Jay-esp/CB-radio-Cybernet-platform-PLL-controller/cb_pllcontrol_1_0_topview2.png

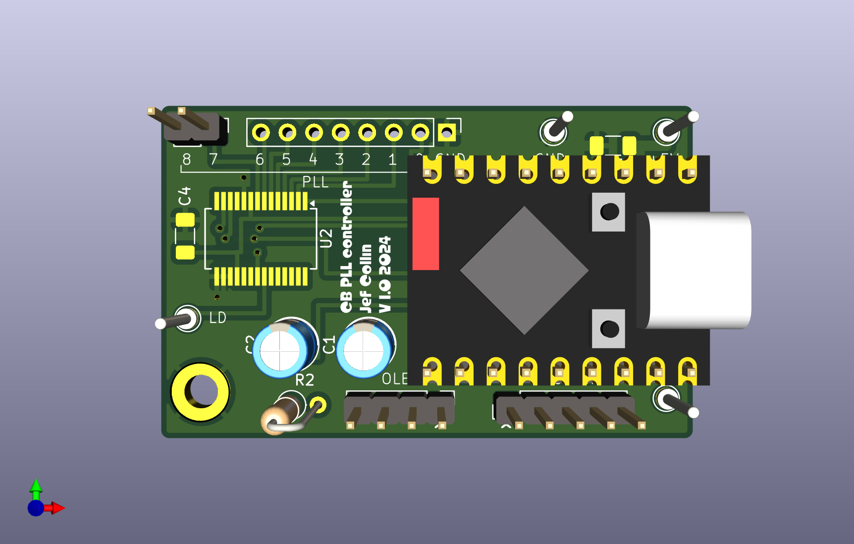
cb_pllcontrol_1_0_topview2.png
