Jay-esp/CB-radio-Cybernet-platform-PLL-controller/cb_pllcontrol_1_0.pdf

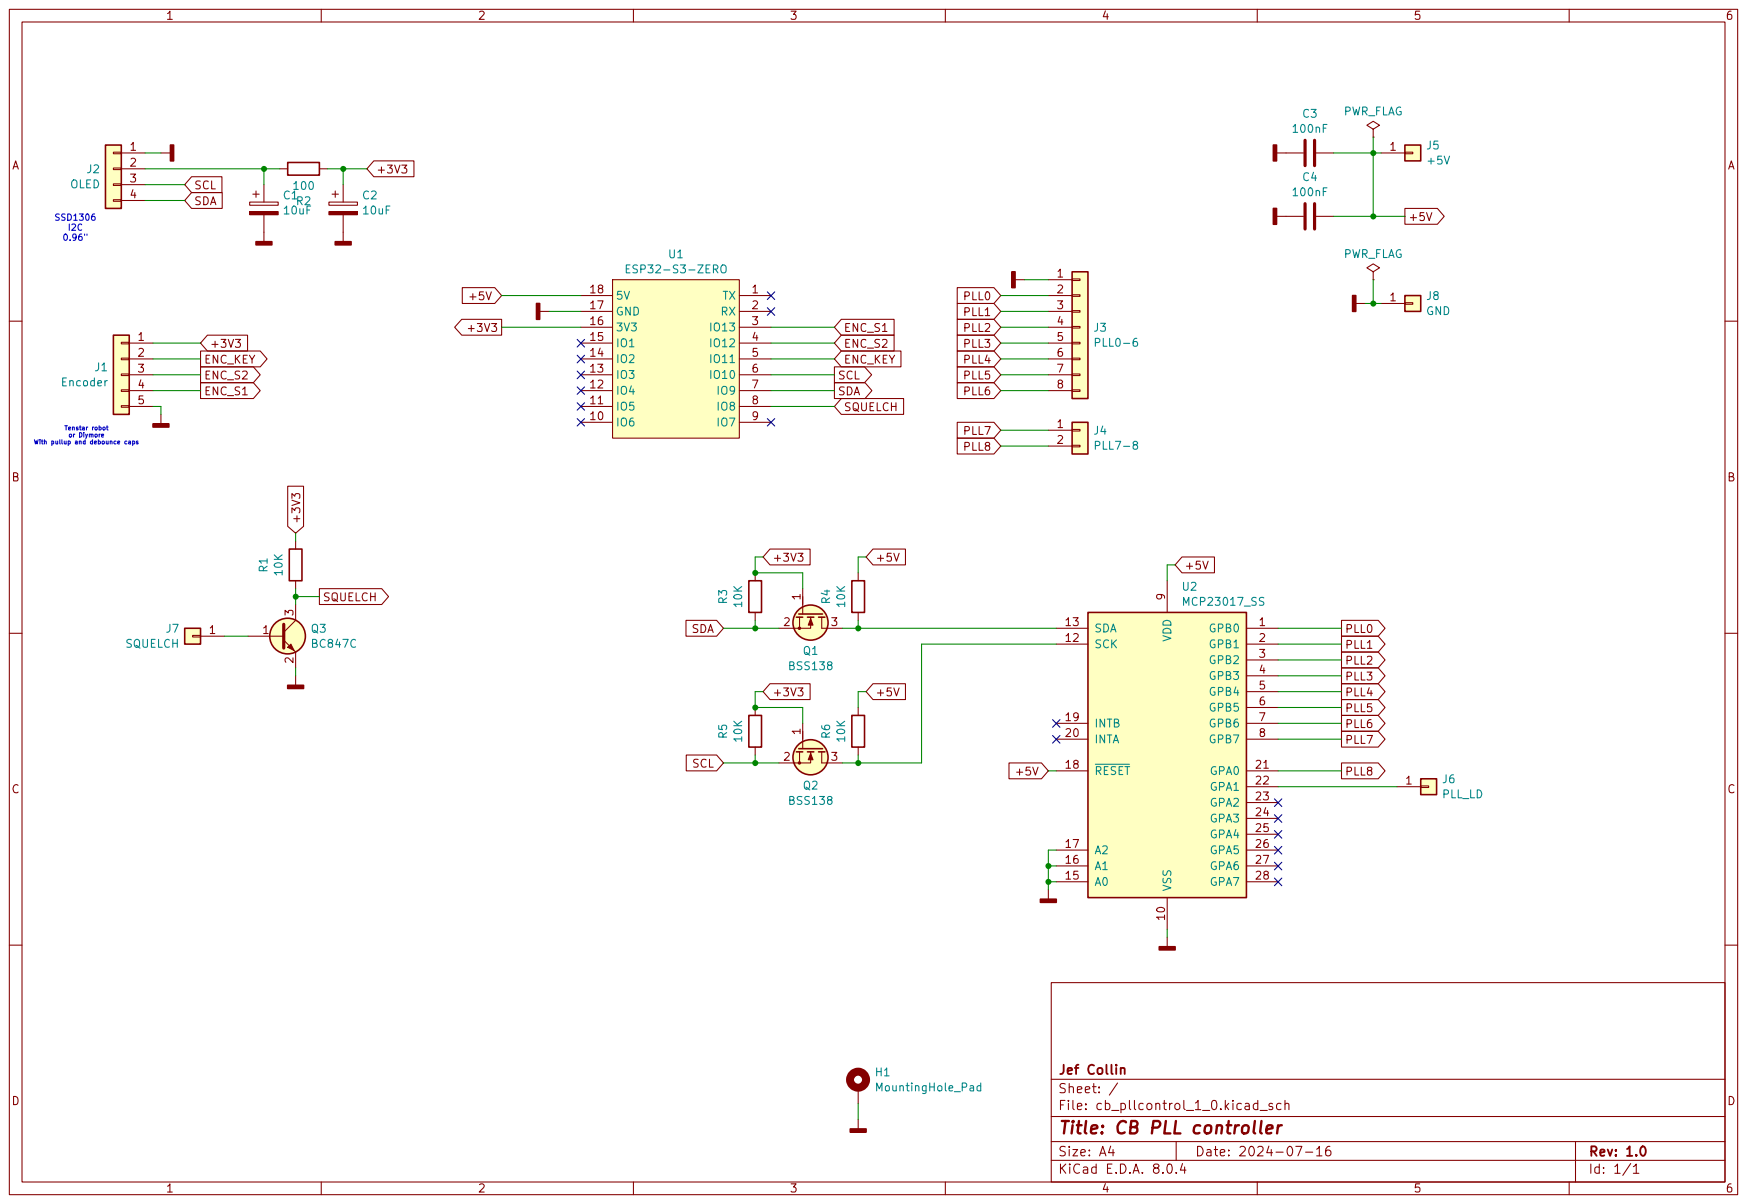
[picture p34: page 1]
