Jay-esp/CB-radio-Cybernet-platform-PLL-controller/CB_PLL_1_2/Roboto_Regular10pt7b.h

const uint8_t Roboto_Regular10pt7bBitmaps[] PROGMEM = {
  0x00, 0xFA, 0xAA, 0xA0, 0xF0, 0xDD, 0xDD, 0x90, 0x0C, 0xC1, 0x10, 0x22,
  0x3F, 0xF1, 0x98, 0x33, 0x04, 0x40, 0x88, 0xFF, 0xC6, 0x60, 0xCC, 0x19,
  0x02, 0x20, 0x44, 0x00, 0x0C, 0x06, 0x0F, 0x8F, 0xE6, 0x3A, 0x0D, 0x86,
  0xE0, 0x3E, 0x07, 0x80, 0xE0, 0x3C, 0x1F, 0x0D, 0xFC, 0x7C, 0x08, 0x04,
  0x00, 0x78, 0x06, 0x40, 0x23, 0x11, 0x19, 0x88, 0xC8, 0x64, 0x81, 0xEC,
  0x00, 0x5E, 0x05, 0x90, 0x68, 0xC2, 0x46, 0x22, 0x33, 0x19, 0x00, 0x78,
  0x1E, 0x07, 0xE1, 0x8C, 0x31, 0x86, 0x30, 0x7C, 0x06, 0x03, 0xE0, 0xC6,
  0x78, 0x6B, 0x07, 0x70, 0xC7, 0xFC, 0x7C, 0xC0, 0xF8, 0x08, 0xC4, 0x66,
  0x31, 0x88, 0xC6, 0x31, 0x8C, 0x21, 0x8C, 0x61, 0x84, 0x30, 0x80, 0x81,
  0x82, 0x0C, 0x10, 0x61, 0x86, 0x08, 0x30, 0xC3, 0x08, 0x61, 0x86, 0x10,
  0xC2, 0x18, 0x80, 0x08, 0x08, 0x49, 0xFF, 0x18, 0x3C, 0x26, 0x62, 0x0C,
  0x03, 0x00, 0xC0, 0x30, 0xFF, 0xFF, 0xF0, 0xC0, 0x30, 0x0C, 0x03, 0x00,
  0xC0, 0x6D, 0xAC, 0xFF, 0xC0, 0x7C, 0x03, 0x02, 0x06, 0x04, 0x0C, 0x08,
  0x08, 0x18, 0x10, 0x30, 0x30, 0x20, 0x60, 0x40, 0xC0, 0x3E, 0x3F, 0x98,
  0xF8, 0x3C, 0x1E, 0x0F, 0x07, 0x83, 0xC1, 0xE0, 0xF0, 0x6C, 0x77, 0xF1,
  0xF0, 0x0B, 0xFF, 0x31, 0x8C, 0x63, 0x18, 0xC6, 0x31, 0x8C, 0x3E, 0x1F,
  0xCE, 0x3B, 0x06, 0x01, 0x80, 0x40, 0x30, 0x18, 0x0C, 0x06, 0x03, 0x01,
  0x80, 0xFF, 0xFF, 0xF0, 0x3E, 0x3F, 0xB8, 0xF8, 0x30, 0x18, 0x18, 0x78,
  0x3E, 0x03, 0x80, 0xF0, 0x7C, 0x77, 0xF1, 0xF0, 0x03, 0x01, 0xC0, 0xF0,
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
  {   503,   8,  14,  11,    2,  -13 },   // 0x46 'F'
  {   517,  11,  14,  14,    1,  -13 },   // 0x47 'G'
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

const GFXfont Roboto_Regular10pt7b PROGMEM = {
  (uint8_t  *)Roboto_Regular10pt7bBitmaps,
  (GFXglyph *)Roboto_Regular10pt7bGlyphs,
  0x20, 0x7E, 23 };

// Approx. 2018 bytes
