Jay-esp/CB-radio-Cybernet-platform-PLL-controller/CB_PLL_1_2/Roboto_Regular11pt7b.h

const uint8_t Roboto_Regular11pt7bBitmaps[] PROGMEM = {
  0x00, 0xFF, 0xFF, 0xFF, 0x0F, 0xDE, 0xF7, 0xBD, 0x80, 0x06, 0x60, 0x46,
  0x0C, 0x40, 0xC4, 0x7F, 0xF7, 0xFF, 0x08, 0xC1, 0x88, 0x18, 0x8F, 0xFE,
  0xFF, 0xE1, 0x18, 0x11, 0x83, 0x10, 0x31, 0x03, 0x30, 0x04, 0x01, 0x01,
  0xF0, 0xFE, 0x71, 0xD8, 0x36, 0x0D, 0x80, 0x78, 0x0F, 0x80, 0xF8, 0x07,
  0x00, 0xF0, 0x3C, 0x0D, 0x87, 0x7F, 0x87, 0xC0, 0xC0, 0x30, 0x78, 0x01,
  0x10, 0x0C, 0x42, 0x31, 0x98, 0xC4, 0x41, 0x13, 0x03, 0x88, 0x00, 0x40,
  0x03, 0x00, 0x09, 0xE0, 0x6C, 0xC3, 0x21, 0x08, 0x84, 0x62, 0x11, 0x0C,
  0xC0, 0x1E, 0x1E, 0x01, 0xF8, 0x0C, 0x60, 0xC3, 0x06, 0x18, 0x19, 0x80,
  0xF8, 0x03, 0x80, 0x3C, 0x03, 0x31, 0xB0, 0xCD, 0x83, 0xCC, 0x0E, 0x70,
  0xF1, 0xFF, 0x83, 0xE7, 0xFF, 0xC0, 0x04, 0x31, 0x8C, 0x31, 0x86, 0x18,
  0x61, 0x0C, 0x30, 0xC1, 0x86, 0x18, 0x61, 0x83, 0x0C, 0x18, 0x30, 0x40,
  0x43, 0x82, 0x0C, 0x18, 0x61, 0x83, 0x0C, 0x30, 0xC3, 0x0C, 0x30, 0xC3,
  0x18, 0x61, 0x8C, 0x21, 0x8C, 0x00, 0x0C, 0x06, 0x03, 0x0D, 0x3F, 0xF8,
  0x60, 0x78, 0x6C, 0x63, 0x00, 0x0C, 0x01, 0x80, 0x30, 0x06, 0x00, 0xC1,
  0xFF, 0xFF, 0xF8, 0x60, 0x0C, 0x01, 0x80, 0x30, 0x06, 0x00, 0x6D, 0xBC,
  0xFF, 0xF0, 0xF0, 0x01, 0x03, 0x02, 0x06, 0x06, 0x04, 0x0C, 0x0C, 0x18,
  0x18, 0x10, 0x30, 0x30, 0x20, 0x60, 0x40, 0xC0, 0x1F, 0x0F, 0xE6, 0x19,
  0x83, 0xC0, 0xF0, 0x3C, 0x0F, 0x03, 0xC0, 0xF0, 0x3C, 0x0F, 0x03, 0x60,
  0xDC, 0x63, 0xF8, 0x7C, 0x0D, 0xFF, 0xE3, 0x0C, 0x30, 0xC3, 0x0C, 0x30,
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
  {   616,  10,  16,  12,    2,  -15 },   // 0x46 'F'
  {   636,  12,  16,  15,    1,  -15 },   // 0x47 'G'
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

const GFXfont Roboto_Regular11pt7b PROGMEM = {
  (uint8_t  *)Roboto_Regular11pt7bBitmaps,
  (GFXglyph *)Roboto_Regular11pt7bGlyphs,
  0x20, 0x7E, 25 };

// Approx. 2305 bytes
