Jay-esp/CB-radio-Cybernet-platform-PLL-controller/CB_PLL_1_2/Roboto_Regular7pt7b.h

const uint8_t Roboto_Regular7pt7bBitmaps[] PROGMEM = {
  0x00, 0xAA, 0xA8, 0x30, 0xB6, 0xD0, 0x12, 0x28, 0x97, 0xF2, 0x44, 0xBF,
  0xA4, 0x48, 0x90, 0x10, 0x47, 0xB3, 0x87, 0x06, 0x06, 0x06, 0x1C, 0xDE,
  0x20, 0xE0, 0x49, 0x25, 0x12, 0x8E, 0x80, 0xB8, 0x52, 0x49, 0x44, 0x83,
  0x80, 0x78, 0x48, 0xC8, 0x58, 0x30, 0xF2, 0x9A, 0x8E, 0x8C, 0x7B, 0xE0,
  0x23, 0x44, 0x88, 0x88, 0x88, 0x44, 0x23, 0x84, 0x22, 0x31, 0x11, 0x13,
  0x22, 0x48, 0x10, 0x4E, 0xCC, 0x71, 0x20, 0x30, 0xC3, 0x3F, 0x30, 0xC3,
  0x00, 0x58, 0xF0, 0xC0, 0x08, 0x44, 0x21, 0x10, 0x8C, 0x42, 0x20, 0x7B,
  0x38, 0x61, 0x86, 0x18, 0x61, 0xCD, 0xE0, 0x3D, 0x11, 0x11, 0x11, 0x11,
  0x7A, 0x38, 0x41, 0x08, 0x63, 0x18, 0xC3, 0xF0, 0x7A, 0x38, 0x42, 0x30,
  0x30, 0x61, 0x8D, 0xE0, 0x04, 0x0C, 0x14, 0x14, 0x24, 0x64, 0x44, 0xFF,
  0x04, 0x04, 0x7D, 0x04, 0x1E, 0xCC, 0x10, 0x61, 0xCD, 0xE0, 0x39, 0x8C,
  0x2E, 0xCE, 0x18, 0x61, 0x4D, 0xE0, 0xFC, 0x10, 0x82, 0x18, 0x43, 0x08,
  0x61, 0x00, 0x7B, 0x38, 0x73, 0x73, 0x38, 0x61, 0xCD, 0xE0, 0x73, 0x28,
  0xE1, 0x87, 0x37, 0x42, 0x19, 0xC0, 0x90, 0x03, 0x40, 0x01, 0x70, 0x04,
  0x76, 0x38, 0x1C, 0x10, 0xFC, 0x00, 0x3F, 0x81, 0x81, 0xC7, 0xE2, 0x00,
  0x74, 0xC2, 0x11, 0x18, 0x8C, 0x03, 0x00, 0x1F, 0x04, 0x11, 0x01, 0x67,
  0x18, 0x93, 0x22, 0x64, 0x8C, 0x91, 0x92, 0x53, 0xB9, 0x00, 0x31, 0x01,
  0xF0, 0x08, 0x0E, 0x05, 0x02, 0x82, 0x21, 0x11, 0xFC, 0x82, 0x41, 0x60,
  0xC0, 0xFD, 0x0A, 0x1C, 0x2F, 0x90, 0xE0, 0xC1, 0x87, 0xF8, 0x3C, 0x8F,
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
  {   252,   6,  10,   8,    1,   -9 },   // 0x46 'F'
  {   260,   8,  10,  10,    1,   -9 },   // 0x47 'G'
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

const GFXfont Roboto_Regular7pt7b PROGMEM = {
  (uint8_t  *)Roboto_Regular7pt7bBitmaps,
  (GFXglyph *)Roboto_Regular7pt7bGlyphs,
  0x20, 0x7E, 16 };

// Approx. 1353 bytes
