Jay-esp/CB-radio-Cybernet-platform-PLL-controller/CB_PLL_1_2/Roboto_Regular8pt7b.h

const uint8_t Roboto_Regular8pt7bBitmaps[] PROGMEM = {
  0x00, 0xFF, 0xFF, 0x0F, 0xB6, 0xD0, 0x1B, 0x09, 0x04, 0x8F, 0xF3, 0x21,
  0x30, 0x91, 0xFE, 0x24, 0x12, 0x19, 0x09, 0x80, 0x10, 0x20, 0xF2, 0x3C,
  0x78, 0x50, 0x38, 0x1C, 0x0C, 0x0C, 0x1C, 0x6F, 0x84, 0x00, 0x70, 0x24,
  0x49, 0x22, 0x48, 0x74, 0x01, 0x00, 0x80, 0x6E, 0x16, 0x49, 0x12, 0x64,
  0x0E, 0x38, 0x32, 0x11, 0x08, 0x87, 0x81, 0x81, 0xE5, 0x92, 0x8D, 0x43,
  0xB1, 0xCF, 0xB0, 0xF0, 0x13, 0x24, 0x4C, 0xCC, 0x8C, 0xCC, 0x44, 0x23,
  0x10, 0x84, 0x22, 0x31, 0x11, 0x11, 0x11, 0x32, 0x24, 0x80, 0x10, 0x23,
  0xF8, 0x82, 0x89, 0x80, 0x10, 0x20, 0x47, 0xF1, 0x02, 0x04, 0x08, 0x57,
  0xF0, 0xF0, 0x04, 0x30, 0x82, 0x10, 0x41, 0x08, 0x21, 0x84, 0x10, 0xC0,
  0x38, 0x8B, 0x1C, 0x18, 0x30, 0x60, 0xC1, 0x83, 0x8D, 0x11, 0xC0, 0x1B,
  0xF6, 0x31, 0x8C, 0x63, 0x18, 0xC6, 0x30, 0x79, 0x8A, 0x1C, 0x30, 0x60,
  0x83, 0x0C, 0x30, 0xC3, 0x07, 0xF0, 0x79, 0x8A, 0x18, 0x30, 0x47, 0x01,
  0x03, 0x07, 0x0F, 0x13, 0xC0, 0x06, 0x03, 0x02, 0x83, 0x41, 0x21, 0x90,
  0x88, 0x84, 0xFF, 0x81, 0x00, 0x80, 0x40, 0x7E, 0x81, 0x02, 0x07, 0xC8,
  0xC0, 0x81, 0x03, 0x85, 0x19, 0xE0, 0x1C, 0x41, 0x06, 0x0F, 0xD8, 0xF0,
  0xC1, 0xC3, 0x85, 0x99, 0xE0, 0xFE, 0x04, 0x18, 0x20, 0xC1, 0x06, 0x08,
  0x10, 0x60, 0x83, 0x00, 0x78, 0x8B, 0x1E, 0x34, 0x47, 0x11, 0x41, 0x83,
  0x07, 0x1B, 0xE0, 0x79, 0x9A, 0x1C, 0x38, 0x70, 0xF1, 0xBF, 0x06, 0x08,
  0x33, 0x80, 0xF0, 0x03, 0xC0, 0x6C, 0x00, 0x03, 0x4B, 0x00, 0x04, 0x77,
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
  {   342,   7,  12,   9,    1,  -11 },   // 0x46 'F'
  {   353,   9,  12,  11,    1,  -11 },   // 0x47 'G'
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

const GFXfont Roboto_Regular8pt7b PROGMEM = {
  (uint8_t  *)Roboto_Regular8pt7bBitmaps,
  (GFXglyph *)Roboto_Regular8pt7bGlyphs,
  0x20, 0x7E, 18 };

// Approx. 1582 bytes
