Jay-esp/CB-radio-Cybernet-platform-PLL-controller/CB_PLL_1_2/Roboto_Regular9pt7b.h

const uint8_t Roboto_Regular9pt7bBitmaps[] PROGMEM = {
  0x00, 0xFD, 0x55, 0x41, 0xC0, 0x99, 0x99, 0x09, 0x82, 0x61, 0x90, 0x64,
  0x7F, 0xC4, 0xC1, 0x30, 0xC8, 0xFF, 0x88, 0x82, 0x60, 0x98, 0x64, 0x00,
  0x08, 0x08, 0x3C, 0x62, 0x43, 0xC3, 0x40, 0x60, 0x38, 0x06, 0x03, 0xC1,
  0xC3, 0x43, 0x3E, 0x18, 0x18, 0x70, 0x11, 0x12, 0x26, 0x44, 0x88, 0xA0,
  0xE4, 0x01, 0x00, 0x6E, 0x0B, 0x22, 0x44, 0x48, 0x91, 0x90, 0x1C, 0x3C,
  0x19, 0x86, 0x21, 0x98, 0x6C, 0x0E, 0x03, 0x81, 0xB2, 0xCC, 0xB1, 0xEC,
  0x31, 0x0E, 0x3C, 0xC0, 0xF0, 0x08, 0x88, 0xC4, 0x23, 0x18, 0xC6, 0x31,
  0x84, 0x21, 0x84, 0x10, 0x40, 0x82, 0x08, 0x61, 0x0C, 0x63, 0x18, 0xC6,
  0x31, 0x88, 0xC4, 0x44, 0x00, 0x18, 0x18, 0x9A, 0xFE, 0x19, 0x3C, 0x64,
  0x46, 0x18, 0x18, 0x18, 0x18, 0xFF, 0x18, 0x18, 0x18, 0x18, 0x6D, 0x60,
  0xF8, 0xF0, 0x06, 0x08, 0x10, 0x60, 0x83, 0x04, 0x08, 0x30, 0x41, 0x83,
  0x04, 0x18, 0x00, 0x3C, 0x66, 0xC3, 0xC3, 0xC3, 0xC3, 0xC3, 0xC3, 0xC3,
  0xC3, 0xC3, 0x66, 0x3C, 0x09, 0xF2, 0x10, 0x84, 0x21, 0x08, 0x42, 0x10,
  0x80, 0x3C, 0x46, 0xC3, 0x83, 0x03, 0x02, 0x06, 0x0C, 0x18, 0x30, 0x20,
  0x40, 0xFF, 0x3C, 0x46, 0xC3, 0xC3, 0x03, 0x06, 0x3C, 0x06, 0x03, 0x83,
  0xC3, 0xC2, 0x3C, 0x03, 0x01, 0xC0, 0x70, 0x3C, 0x1B, 0x04, 0xC3, 0x30,
  0x8C, 0x63, 0x3F, 0xF0, 0x30, 0x0C, 0x03, 0x00, 0x7F, 0x60, 0x60, 0x60,
  0x7E, 0x63, 0x03, 0x01, 0x01, 0xC1, 0x43, 0x63, 0x3C, 0x0C, 0x30, 0x60,
  0x40, 0xDC, 0xE2, 0xC3, 0xC1, 0xC1, 0xC1, 0x43, 0x62, 0x3C, 0xFF, 0x03,
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
  {   419,   8,  13,  10,    1,  -12 },   // 0x46 'F'
  {   432,  10,  13,  12,    1,  -12 },   // 0x47 'G'
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

const GFXfont Roboto_Regular9pt7b PROGMEM = {
  (uint8_t  *)Roboto_Regular9pt7bBitmaps,
  (GFXglyph *)Roboto_Regular9pt7bGlyphs,
  0x20, 0x7E, 21 };

// Approx. 1792 bytes
