Jay-esp/CB-radio-Cybernet-platform-PLL-controller/CB_PLL_1_2_large/myfonts.h

/*
  Fontname: -*-DIN 1451 Mittelschrift-Medium-R-Normal--13-100-96-96-c-4--fontspecific
  Copyright: You may wish to put your copyright here
  Glyphs: 96/226
  BBX Build Mode: 0
*/

const uint8_t DIN1451Mittelschrift_10_r[1200] U8G2_FONT_SECTION("DIN1451Mittelschrift_10_r") = 
  "`\0\3\3\4\4\2\4\5\13\15\0\375\11\375\11\377\1~\3!\4\223 \5\0\342\4!\11\222\343"
  "\304$o\21\0\42\7$>Md\22#\23\226\242U$\26\211E\42\226P\304\222\26\211EB\0$"
  "\22\266\236U\260\42\11\11\245\263\210(R\221\320b\0%\20\225\343\205h\22\221\304\202\261`d\22\21"
  "\11&\22\227#\316\60\42\213\310f\264\220D&\211\211&\2'\6!\377\204\0(\12\242\37MD\222"
  "\247H\0)\16\243\36E,\24\22\245HB\221\20\0*\11DvED\205\24\1+\12v#V\64"
  "\315\24M\3,\6!\337\204\0-\6\24o\5\1.\6\21\343D\0/\13\224\42]R,)\226\24"
  "\3\60\16\226\242\15)\304\223$$\11I(\0\61\10\223\243\315$\224\37\62\15\226\242\15)\64\23\6"
  "e\212A\3\63\16\226\242\15E\24\25\306\246QR\210\2\64\15\226\242\235b\64\30\312r(F\0\65"
  "\16\226\242M%\32%\205\204B\222\204\2\66\17\226\242\235bPH\12\221$!\11\5\0\67\15\225\243"
  "\205I\26S\213\311b\62\0\70\21\226\242\15)D\222\204B\24\21-\22\222P\0\71\17\226\242\15)"
  "D\222\204$DaP&\3:\7A\343D(\0;\7Q\337DH\0<\12v#nl\42\13+"
  "\7=\7F'\206\35j>\13v#Ft\71&\222E\1\77\15\225\242\215)\30\223\305\324!\22\0"
  "@\25\232\242\226M\32\12Q\262EJ)\262H(b\213\312J\0A\21\230\42\236XJ\14\5C\61"
  "\221\310\24\214\10\5B\13\226#\306Q\355 T\273\0C\14\226\343\15E\64\315q$\241\0D\20\227"
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
  "\243D\210\342\315\37\24\61\310\20C\34o~O\300\60\324a\305\11\0{\13h\206p\5\311\310\377\237"
  "I|\13h\206p\5\311\310\377\237I}\13h\206p\5\311\310\377\237I~\13h\206p\5\311\310\377"
  "\237I\177\13h\206p\5\311\310\377\237I\0\0\0\4\377\377\0";
