Jay-esp/CB-radio-Cybernet-platform-PLL-controller/CB_PLL_1_2/DIN_1451_Mittelschrift_Regular10pt7b.h

const uint8_t DIN_1451_Mittelschrift_Regular10pt7bBitmaps[] PROGMEM = {
  0x00, 0xFF, 0xFF, 0xF0, 0xF0, 0xFF, 0xF0, 0x11, 0x09, 0x8C, 0xC6, 0x6F,
  0xFF, 0xFC, 0xC8, 0x4C, 0xFF, 0xFF, 0xD9, 0x8C, 0xC6, 0x42, 0x20, 0x08,
  0x0F, 0x0F, 0xED, 0x26, 0x83, 0x41, 0xE0, 0x7C, 0x1F, 0x05, 0xC2, 0x61,
  0x34, 0xBB, 0xF8, 0xF8, 0x10, 0x08, 0x00, 0x61, 0x92, 0x92, 0x94, 0x64,
  0x08, 0x08, 0x10, 0x10, 0x37, 0x25, 0x65, 0x45, 0xC7, 0x1C, 0x07, 0xE0,
  0x63, 0x06, 0x30, 0x77, 0x03, 0xE0, 0x3C, 0x06, 0xE0, 0xC7, 0x6C, 0x3E,
  0xC1, 0xCE, 0x3C, 0x7F, 0x63, 0xE7, 0x7C, 0x12, 0x66, 0x4C, 0xCC, 0xCC,
  0xC4, 0x66, 0x21, 0x84, 0x66, 0x23, 0x33, 0x33, 0x32, 0x66, 0x48, 0x25,
  0x5C, 0xEA, 0x90, 0x0C, 0x03, 0x00, 0xC0, 0x30, 0xFF, 0xFF, 0xF0, 0xC0,
  0x30, 0x0C, 0x03, 0x00, 0xF8, 0xFF, 0xF0, 0xF0, 0x04, 0x30, 0xC2, 0x18,
  0x61, 0x0C, 0x30, 0x86, 0x18, 0x43, 0x00, 0x3C, 0x7E, 0xE7, 0xC3, 0xC3,
  0xC3, 0xC3, 0xC3, 0xC3, 0xC3, 0xC3, 0xE7, 0x7E, 0x3C, 0x7F, 0xB3, 0x33,
  0x33, 0x33, 0x33, 0x33, 0x3C, 0x7E, 0xE7, 0xC3, 0x03, 0x07, 0x06, 0x0C,
  0x18, 0x38, 0x70, 0xE0, 0xFF, 0xFF, 0x3C, 0x7E, 0xE7, 0xC3, 0x03, 0x07,
  0x1E, 0x1E, 0x07, 0x03, 0x03, 0xC7, 0x7E, 0x3C, 0x06, 0x06, 0x03, 0x03,
  0x01, 0x81, 0x80, 0xCC, 0xC6, 0x63, 0x71, 0xBF, 0xFF, 0xF0, 0x30, 0x18,
  0xFF, 0xFF, 0xC0, 0xC0, 0xFC, 0xFE, 0xE7, 0x03, 0x03, 0x03, 0xC3, 0xC7,
  0x7E, 0x3C, 0x0C, 0x0C, 0x18, 0x18, 0x30, 0x30, 0x7C, 0xFE, 0xE7, 0xC3,
  0xC3, 0xE7, 0x7E, 0x3C, 0xFF, 0xFF, 0xC3, 0xC6, 0x06, 0x0E, 0x0C, 0x0C,
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
  {   446,  10,  14,  12,    1,  -13 },   // 0x47 'G'
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

const GFXfont DIN_1451_Mittelschrift_Regular10pt7b PROGMEM = {
  (uint8_t  *)DIN_1451_Mittelschrift_Regular10pt7bBitmaps,
  (GFXglyph *)DIN_1451_Mittelschrift_Regular10pt7bGlyphs,
  0x20, 0x7E, 23 };

// Approx. 1856 bytes
