Jay-esp/CB-radio-Cybernet-platform-PLL-controller/CB_PLL_1_2/DIN_1451_Mittelschrift_Regular9pt7b.h

const uint8_t DIN_1451_Mittelschrift_Regular9pt7bBitmaps[] PROGMEM = {
  0x00, 0xFF, 0xFF, 0xCF, 0xFF, 0xF0, 0x32, 0x32, 0x36, 0xFF, 0x26, 0x24,
  0x64, 0xFF, 0x64, 0x6C, 0x4C, 0x4C, 0x08, 0x08, 0x3E, 0x7E, 0x68, 0x68,
  0x68, 0x3C, 0x1E, 0x0B, 0x0B, 0x4B, 0x7E, 0x3C, 0x08, 0x08, 0xE3, 0x4A,
  0x97, 0x40, 0x82, 0x04, 0x17, 0x2A, 0x95, 0x2C, 0x70, 0x3C, 0x0F, 0xC1,
  0x98, 0x33, 0x03, 0xC0, 0x70, 0x1B, 0x06, 0x36, 0xC3, 0x9C, 0x71, 0xFB,
  0x1E, 0x60, 0x7C, 0x22, 0x64, 0xCC, 0xCC, 0xCC, 0x46, 0x22, 0x84, 0x62,
  0x33, 0x33, 0x33, 0x26, 0x48, 0x27, 0xC9, 0xF2, 0x00, 0x18, 0x0C, 0x06,
  0x03, 0x0F, 0xFF, 0xFC, 0x60, 0x30, 0x18, 0x00, 0xF8, 0xFF, 0xC0, 0xF0,
  0x0C, 0x21, 0x86, 0x10, 0xC2, 0x08, 0x61, 0x04, 0x30, 0x39, 0xFB, 0x1E,
  0x3C, 0x78, 0xF1, 0xE3, 0xC7, 0x8F, 0xF1, 0xC0, 0x7F, 0xB3, 0x33, 0x33,
  0x33, 0x33, 0x38, 0xFB, 0x1E, 0x30, 0x61, 0x86, 0x18, 0x70, 0xC3, 0xFF,
  0xF0, 0x79, 0xFF, 0x18, 0x33, 0xC7, 0x83, 0x83, 0x07, 0x9F, 0xF3, 0xC0,
  0x0C, 0x18, 0x18, 0x30, 0x30, 0x66, 0x66, 0xC6, 0xFF, 0xFF, 0x06, 0x06,
  0xFF, 0xFF, 0x07, 0xEF, 0xD8, 0xC1, 0x83, 0x07, 0x8F, 0xF1, 0xC0, 0x18,
  0x30, 0xC1, 0x87, 0xCF, 0xF1, 0xE3, 0xC7, 0x8D, 0xF1, 0xC0, 0xFF, 0xFF,
  0x1E, 0x60, 0xC1, 0x86, 0x0C, 0x30, 0x60, 0xC3, 0x00, 0x3C, 0xFF, 0xC3,
  0xC3, 0x7E, 0x7E, 0xE7, 0xC3, 0xC3, 0xE7, 0x7E, 0x3C, 0x38, 0xFB, 0x1E,
  0x3C, 0x7F, 0xDF, 0x0E, 0x18, 0x30, 0xC1, 0x80, 0xF0, 0xF0, 0xF0, 0xF8,
  0x01, 0x83, 0xC7, 0x0E, 0x0C, 0x03, 0x80, 0x78, 0x07, 0x00, 0x80, 0xFF,
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
  {   356,   9,  12,  11,    1,  -11 },   // 0x47 'G'
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

const GFXfont DIN_1451_Mittelschrift_Regular9pt7b PROGMEM = {
  (uint8_t  *)DIN_1451_Mittelschrift_Regular9pt7bBitmaps,
  (GFXglyph *)DIN_1451_Mittelschrift_Regular9pt7bGlyphs,
  0x20, 0x7E, 21 };

// Approx. 1607 bytes
