Jay-esp/CB-radio-Cybernet-platform-PLL-controller/CB_PLL_1_2/DSEG7ClassicMini_Regular9pt7b.h

const uint8_t DSEG7ClassicMini_Regular9pt7bBitmaps[] PROGMEM = {
  0x00, 0x00, 0xFC, 0x63, 0x18, 0xC6, 0x31, 0x8C, 0x63, 0xF0, 0xFC, 0x63,
  0x18, 0xC6, 0x31, 0x8C, 0x63, 0xF0, 0xFC, 0x63, 0x18, 0xC6, 0x31, 0x8C,
  0x63, 0xF0, 0xFC, 0x63, 0x18, 0xC6, 0x31, 0x8C, 0x63, 0xF0, 0xFC, 0x63,
  0x18, 0xC6, 0x31, 0x8C, 0x63, 0xF0, 0xFC, 0x63, 0x18, 0xC6, 0x31, 0x8C,
  0x63, 0xF0, 0xFC, 0x63, 0x18, 0xC6, 0x31, 0x8C, 0x63, 0xF0, 0xFC, 0x63,
  0x18, 0xC6, 0x31, 0x8C, 0x63, 0xF0, 0xFC, 0x63, 0x18, 0xC6, 0x31, 0x8C,
  0x63, 0xF0, 0xFC, 0x63, 0x18, 0xC6, 0x31, 0x8C, 0x63, 0xF0, 0xFC, 0x63,
  0x18, 0xC6, 0x31, 0x8C, 0x63, 0xF0, 0x7F, 0x3F, 0x80, 0xF0, 0xFC, 0x63,
  0x18, 0xC6, 0x31, 0x8C, 0x63, 0xF0, 0x7F, 0xD7, 0xF6, 0x01, 0xC0, 0x38,
  0x07, 0x00, 0xE0, 0x1C, 0x01, 0x00, 0x00, 0x02, 0x00, 0xC0, 0x38, 0x07,
  0x00, 0xE0, 0x1C, 0x03, 0xBF, 0xAF, 0xF8, 0x7F, 0xF4, 0x1F, 0xFD, 0x7F,
  0xC7, 0xF4, 0x01, 0x80, 0x30, 0x06, 0x00, 0xC0, 0x18, 0x01, 0x3F, 0x87,
  0xF2, 0x00, 0x40, 0x08, 0x01, 0x00, 0x20, 0x04, 0x00, 0xBF, 0x8F, 0xF8,
  0xFF, 0x9F, 0xD0, 0x0C, 0x03, 0x00, 0xC0, 0x30, 0x0C, 0x01, 0x7F, 0x1F,
  0xC0, 0x04, 0x03, 0x00, 0xC0, 0x30, 0x0C, 0x03, 0x7F, 0x7F, 0xE0, 0x80,
  0x30, 0x0E, 0x01, 0xC0, 0x38, 0x07, 0x00, 0xE0, 0x09, 0xFC, 0x3F, 0x80,
  0x04, 0x01, 0x80, 0x30, 0x06, 0x00, 0xC0, 0x18, 0x01, 0x7F, 0xD7, 0xF2,
  0x00, 0x40, 0x08, 0x01, 0x00, 0x20, 0x04, 0x00, 0x3F, 0x87, 0xF0, 0x00,
  0x80, 0x30, 0x06, 0x00, 0xC0, 0x18, 0x03, 0x3F, 0xAF, 0xF8, 0x7F, 0xD7,
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
  {   506,  11,  18,  15,    2,  -17 },   // 0x47 'G'
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

const GFXfont DSEG7ClassicMini_Regular9pt7b PROGMEM = {
  (uint8_t  *)DSEG7ClassicMini_Regular9pt7bBitmaps,
  (GFXglyph *)DSEG7ClassicMini_Regular9pt7bGlyphs,
  0x20, 0x7E, 19 };

// Approx. 2195 bytes
