Jay-esp/CB-radio-Cybernet-platform-PLL-controller/CB_PLL_1_2/FreeSans7pt7b.h

const uint8_t FreeSans7pt7bBitmaps[] PROGMEM = {
  0x00, 0xFF, 0x40, 0xB6, 0xD0, 0x12, 0x28, 0xD3, 0xF2, 0x44, 0xBF, 0x94,
  0x48, 0x90, 0x10, 0x71, 0x52, 0x95, 0x0E, 0x07, 0x09, 0xD2, 0xA5, 0xF0,
  0x81, 0x00, 0x00, 0x87, 0x88, 0x89, 0x08, 0x90, 0x72, 0x00, 0x00, 0x04,
  0xE0, 0x91, 0x09, 0x11, 0x0E, 0x30, 0x48, 0x48, 0x48, 0x30, 0x52, 0x9A,
  0x8C, 0x8E, 0xFA, 0xF0, 0x29, 0x49, 0x24, 0x99, 0x22, 0x91, 0x24, 0x9A,
  0x49, 0x48, 0x4F, 0x4A, 0x00, 0x00, 0x3F, 0x00, 0x00, 0x00, 0xD8, 0xE0,
  0xC0, 0x10, 0x22, 0x04, 0x44, 0x88, 0x33, 0x68, 0xE1, 0x86, 0x18, 0x61,
  0x89, 0xE0, 0x13, 0xF1, 0x11, 0x11, 0x11, 0x18, 0xCD, 0x0A, 0x10, 0x61,
  0x8C, 0x30, 0x40, 0xFC, 0x38, 0xC9, 0x18, 0x31, 0xC3, 0x80, 0xE1, 0x46,
  0xF8, 0x04, 0x18, 0x71, 0xE2, 0xC9, 0xB3, 0x7F, 0x0C, 0x18, 0x7E, 0x81,
  0x02, 0x07, 0xC8, 0xC0, 0x81, 0x46, 0xF8, 0x31, 0x28, 0x60, 0xFB, 0x38,
  0x61, 0x8D, 0xE0, 0xFC, 0x10, 0x82, 0x10, 0xC2, 0x08, 0x61, 0x00, 0x18,
  0xC9, 0x1A, 0x33, 0xCD, 0x90, 0xA1, 0x46, 0xF8, 0x73, 0x68, 0xE1, 0x8F,
  0x72, 0x43, 0x8B, 0xE0, 0xC0, 0x0C, 0x40, 0x0D, 0xC0, 0x00, 0x33, 0x30,
  0xE0, 0xE0, 0x40, 0xFC, 0x00, 0x00, 0x03, 0x03, 0x03, 0x1D, 0xC8, 0x00,
  0x7B, 0x38, 0x43, 0x18, 0x43, 0x00, 0x00, 0xC0, 0x0F, 0xC0, 0xC3, 0x08,
  0x04, 0x8E, 0xB4, 0xCC, 0xA4, 0x47, 0x22, 0x29, 0x12, 0x4E, 0xE3, 0x00,
  0x0E, 0x00, 0x1F, 0x00, 0x0C, 0x0E, 0x05, 0x02, 0xC2, 0x21, 0x11, 0xFC,
  0x82, 0x41, 0x60, 0xC0, 0xFC, 0x86, 0x82, 0x82, 0xFC, 0x86, 0x82, 0x83,
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
  {   259,   7,  10,   8,    1,   -9 },   // 0x46 'F'
  {   268,   9,  10,  11,    1,   -9 },   // 0x47 'G'
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

const GFXfont FreeSans7pt7b PROGMEM = {
  (uint8_t  *)FreeSans7pt7bBitmaps,
  (GFXglyph *)FreeSans7pt7bGlyphs,
  0x20, 0x7E, 23 };

// Approx. 1354 bytes
