Jay-esp/CB-radio-Cybernet-platform-PLL-controller/CB_PLL_1_2/FreeSans8pt7b.h

const uint8_t FreeSans8pt7bBitmaps[] PROGMEM = {
  0x00, 0xFF, 0x60, 0xBB, 0x98, 0x13, 0x09, 0x04, 0x8F, 0xF3, 0x21, 0x30,
  0x91, 0xFE, 0x24, 0x12, 0x19, 0x00, 0x08, 0x3E, 0x4A, 0x49, 0x48, 0x68,
  0x3E, 0x0B, 0x09, 0x49, 0x4B, 0x7E, 0x08, 0x08, 0x30, 0x42, 0x42, 0x31,
  0x20, 0x89, 0x07, 0x90, 0x18, 0x80, 0x09, 0xC0, 0x99, 0x04, 0x88, 0x44,
  0x42, 0x1E, 0x3C, 0x32, 0x11, 0x0D, 0x83, 0x83, 0xC3, 0x25, 0x1E, 0x86,
  0x63, 0x9F, 0x60, 0xF0, 0x22, 0x44, 0xC8, 0x88, 0x8C, 0x44, 0x22, 0x89,
  0x22, 0x49, 0x2D, 0x25, 0x00, 0x0F, 0x69, 0x10, 0x20, 0x47, 0xF1, 0x02,
  0x04, 0x00, 0xF5, 0xE0, 0xF0, 0x11, 0x12, 0x22, 0x44, 0x48, 0x80, 0x79,
  0x9B, 0x1C, 0x38, 0x70, 0x60, 0xC3, 0x87, 0x89, 0xF0, 0x27, 0x92, 0x49,
  0x24, 0x80, 0x7D, 0x8E, 0x1C, 0x10, 0x61, 0x8E, 0x30, 0xC1, 0x03, 0xF8,
  0x3C, 0x62, 0x43, 0x03, 0x06, 0x1E, 0x03, 0x03, 0x43, 0x43, 0x3E, 0x06,
  0x0E, 0x0E, 0x16, 0x36, 0x66, 0x46, 0xFF, 0x06, 0x06, 0x06, 0x7D, 0x83,
  0x06, 0x0F, 0xD8, 0xC1, 0x81, 0x83, 0x8D, 0xF0, 0x3C, 0x8B, 0x1C, 0x0B,
  0x99, 0xA1, 0xC1, 0x83, 0x8D, 0xF0, 0xFE, 0x04, 0x10, 0x40, 0x82, 0x04,
  0x18, 0x20, 0x41, 0x80, 0x79, 0x8A, 0x1C, 0x36, 0xCF, 0xA1, 0xC1, 0x83,
  0x8D, 0xF0, 0x79, 0x9A, 0x1C, 0x38, 0x78, 0xDE, 0x83, 0x87, 0x89, 0xE0,
  0x83, 0x83, 0x40, 0x06, 0x3B, 0x86, 0x07, 0x01, 0x80, 0x80, 0xFF, 0xFC,
  0x07, 0xF0, 0xC0, 0xE0, 0x38, 0x11, 0xCE, 0x20, 0x00, 0x18, 0xFB, 0x1E,
  0x10, 0x61, 0x86, 0x08, 0x10, 0x00, 0x40, 0x80, 0x03, 0x80, 0x7F, 0x83,
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
  {   317,   8,  11,  10,    1,  -10 },   // 0x46 'F'
  {   328,  10,  12,  12,    1,  -11 },   // 0x47 'G'
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

const GFXfont FreeSans8pt7b PROGMEM = {
  (uint8_t  *)FreeSans8pt7bBitmaps,
  (GFXglyph *)FreeSans8pt7bGlyphs,
  0x20, 0x7E, 26 };

// Approx. 1513 bytes
