Jay-esp/CB-radio-Cybernet-platform-PLL-controller/CB_PLL_1_2/FreeSans6pt7b.h

const uint8_t FreeSans6pt7bBitmaps[] PROGMEM = {
  0x00, 0xF8, 0x80, 0xF0, 0x00, 0x24, 0xA7, 0xCA, 0x0B, 0xF4, 0x14, 0x11,
  0x65, 0x54, 0x70, 0x71, 0x65, 0x78, 0x40, 0x70, 0x24, 0x89, 0x01, 0xD0,
  0x01, 0x82, 0x91, 0x24, 0x47, 0x51, 0x05, 0x18, 0xB6, 0x68, 0xBD, 0xC0,
  0x12, 0xAA, 0x84, 0x89, 0x12, 0x49, 0x29, 0x00, 0x23, 0x24, 0x21, 0x09,
  0xF2, 0x10, 0xA0, 0xC0, 0x80, 0x04, 0x84, 0x84, 0x80, 0x79, 0x14, 0x51,
  0x45, 0x14, 0x5E, 0x3C, 0x92, 0x49, 0x79, 0x14, 0x43, 0x11, 0x84, 0x3F,
  0x79, 0x10, 0x46, 0x0C, 0x14, 0x5E, 0x08, 0x62, 0x92, 0x4B, 0xF0, 0x82,
  0x7D, 0x04, 0x1A, 0x04, 0x14, 0x5E, 0x39, 0x14, 0x1E, 0x45, 0x14, 0x5E,
  0xF8, 0x84, 0x42, 0x21, 0x08, 0x79, 0x14, 0x4E, 0x4F, 0x14, 0x5E, 0x79,
  0x1C, 0x51, 0x7C, 0x14, 0xDE, 0xC0, 0x30, 0xC0, 0x36, 0x00, 0xF1, 0x07,
  0x04, 0xF8, 0x3E, 0x06, 0x0C, 0x16, 0x40, 0x74, 0xE2, 0x11, 0x10, 0x80,
  0x20, 0x07, 0x02, 0x18, 0x81, 0xA7, 0x54, 0x93, 0x22, 0x64, 0x4A, 0x7E,
  0x60, 0x06, 0x00, 0x38, 0x00, 0x18, 0x18, 0x18, 0x24, 0x24, 0x64, 0x42,
  0x42, 0xC2, 0xF2, 0x38, 0x61, 0xFA, 0x18, 0x61, 0xF8, 0x38, 0x8A, 0x1C,
  0x08, 0x10, 0x20, 0xE3, 0x7C, 0xF1, 0x1A, 0x14, 0x18, 0x30, 0x61, 0xC2,
  0xF8, 0xFE, 0x08, 0x20, 0xFE, 0x08, 0x20, 0xFC, 0xFE, 0x08, 0x20, 0xFA,
  0x08, 0x20, 0x80, 0x38, 0x8E, 0x0C, 0x08, 0xF0, 0x60, 0xE1, 0x7C, 0x87,
  0x0E, 0x1C, 0x3F, 0xF0, 0xE1, 0xC3, 0x86, 0xFF, 0x80, 0x08, 0x42, 0x10,
  0x86, 0x31, 0x70, 0x87, 0x1A, 0x65, 0x8F, 0x1A, 0x22, 0x46, 0x84, 0x84,
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
  {   188,   6,   9,   7,    1,   -8 },   // 0x46 'F'
  {   195,   7,   9,   9,    1,   -8 },   // 0x47 'G'
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

const GFXfont FreeSans6pt7b PROGMEM = {
  (uint8_t  *)FreeSans6pt7bBitmaps,
  (GFXglyph *)FreeSans6pt7bGlyphs,
  0x20, 0x7E, 20 };

// Approx. 1186 bytes
